TaiHHe/ECE-477/PCB_Relay/Nowboard.brd

## EAGLE design PCB_Relay/Nowboard.brd (2019-04-04)

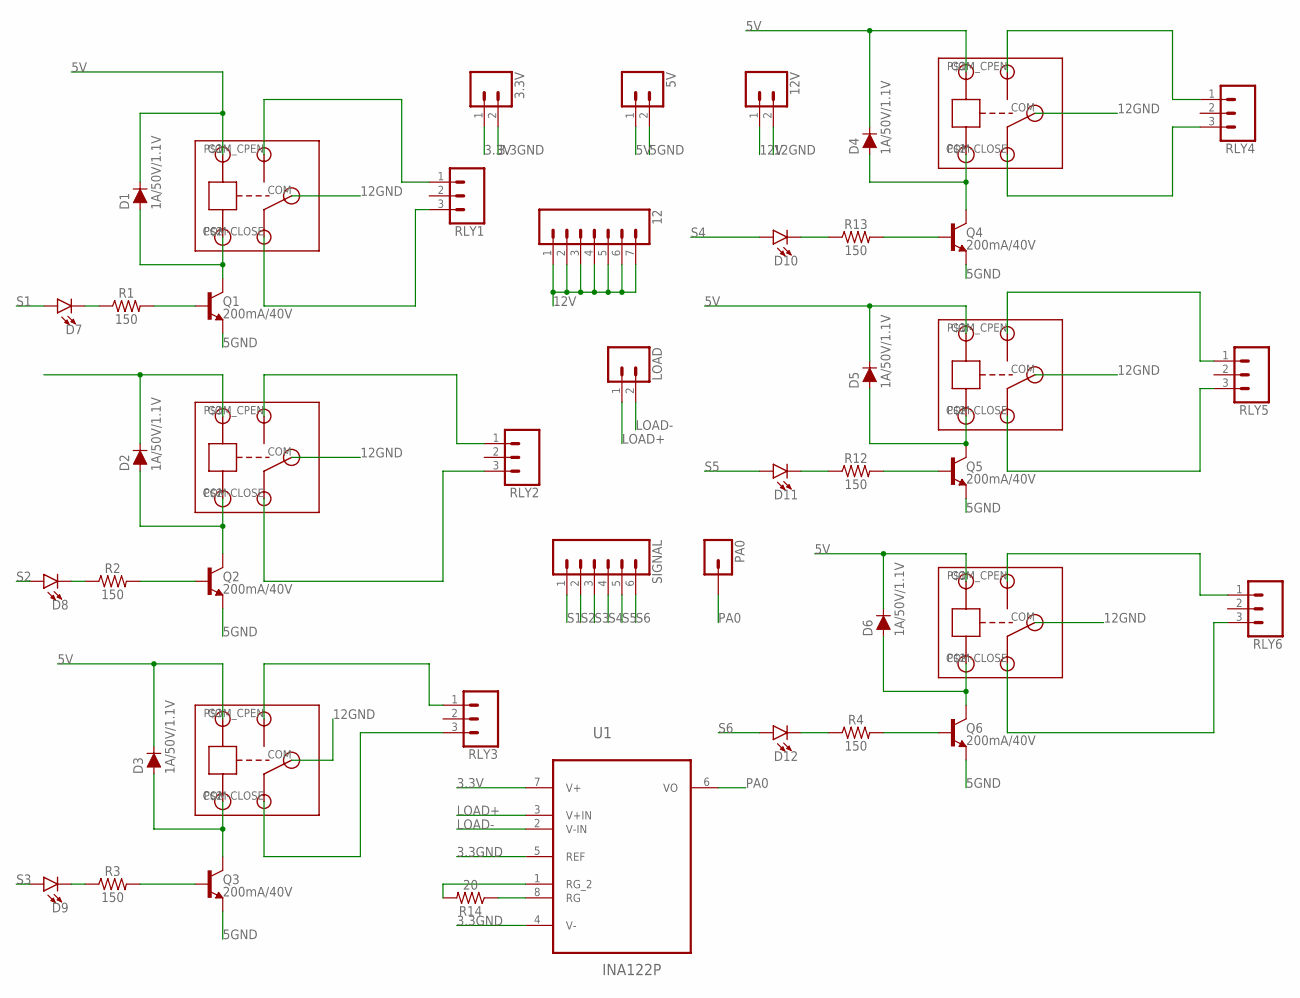
[picture p1: schematic Nowboard.sch]

Parts:
3.3V, 5V, 12V: CONN_02; 1X02
12: CONN_07; 1X07
D1, D2, D3, D4, D5, D6: 1A/50V/1.1V; DIODE-1N4001
D7, D8, D9, D10, D11, D12: LED3MM; LED_3MM
LOAD: CONN_02; 1X02
PA0: CONN_01; 1X01
Q1, Q2, Q3, Q4, Q5, Q6: 200mA/40V; TO-92
R1, R2, R3, R4, R12, R13: 150; 0603
R14: 20; 0603
RELAY1, RELAY2, RELAY3, RELAY4, RELAY5, RELAY6: RELAY
RLY1, RLY2, RLY3, RLY4, RLY5, RLY6: CONN_03; 1X03
SIGNAL: CONN_06NO_SILK_FEMALE_PTH; 1X06_NO_SILK
U1: INA122P; DIP254P762X508-8

Connections:
3.3GND: 3.3V.2, U1.4 (V-), U1.5 (REF)
3.3V: 3.3V.1, U1.7 (V+)
5GND: 5V.2, Q1.1 (E), Q2.1 (E), Q3.1 (E), Q4.1 (E), Q5.1 (E), Q6.1 (E)
5V: 5V.1, D1.C, D3.C, D4.C, D5.C, D6.C, RELAY1.P$1 (IN), RELAY3.P$1 (IN), RELAY4.P$1 (IN), RELAY5.P$1 (IN), RELAY6.P$1 (IN)
12GND: 12V.2, RELAY1.COM, RELAY2.COM, RELAY3.COM, RELAY4.COM, RELAY5.COM, RELAY6.COM
12V: 12.1, 12.2, 12.3, 12.4, 12.5, 12.6, 12.7, 12V.1
LOAD+: LOAD.1, U1.3 (V+IN)
LOAD-: LOAD.2, U1.2 (V-IN)
unnamed: D1.A, Q1.3 (C), RELAY1.P$2 (GND)
unnamed: R14.1, U1.8 (RG)
unnamed: RELAY3.COM-CLOSE, RLY3.3
unnamed: RELAY4.COM_CPEN (COM-OPEN), RLY4.1
unnamed: D2.A, Q2.3 (C), RELAY2.P$2 (GND)
unnamed: D3.A, Q3.3 (C), RELAY3.P$2 (GND)
unnamed: D6.A, Q6.3 (C), RELAY6.P$2 (GND)
unnamed: D5.A, Q5.3 (C), RELAY5.P$2 (GND)
unnamed: D4.A, Q4.3 (C), RELAY4.P$2 (GND)
unnamed: Q4.2 (B), R13.2
unnamed: Q5.2 (B), R12.2
unnamed: Q6.2 (B), R4.2
unnamed: D12.K (C), R4.1
unnamed: D11.K (C), R12.1
unnamed: D10.K (C), R13.1
unnamed: Q3.2 (B), R3.2
unnamed: D9.K (C), R3.1
unnamed: D8.K (C), R2.1
unnamed: Q2.2 (B), R2.2
unnamed: D7.K (C), R1.1
unnamed: Q1.2 (B), R1.2
unnamed: RELAY1.COM-CLOSE, RLY1.3
unnamed: RELAY1.COM_CPEN (COM-OPEN), RLY1.1
unnamed: RELAY2.COM-CLOSE, RLY2.3
unnamed: D2.C, RELAY2.P$1 (IN)
unnamed: RELAY4.COM-CLOSE, RLY4.3
unnamed: RELAY3.COM_CPEN (COM-OPEN), RLY3.1
unnamed: RELAY2.COM_CPEN (COM-OPEN), RLY2.1
unnamed: RELAY6.COM-CLOSE, RLY6.3
unnamed: RELAY6.COM_CPEN (COM-OPEN), RLY6.1
unnamed: RELAY5.COM-CLOSE, RLY5.3
unnamed: RELAY5.COM_CPEN (COM-OPEN), RLY5.1
unnamed: R14.2, U1.1 (RG_2)
PA0: PA0.1, U1.6 (VO)
S1: D7.A, SIGNAL.1
S2: D8.A, SIGNAL.2
S3: D9.A, SIGNAL.3
S4: D10.A, SIGNAL.4
S5: D11.A, SIGNAL.5
S6: D12.A, SIGNAL.6

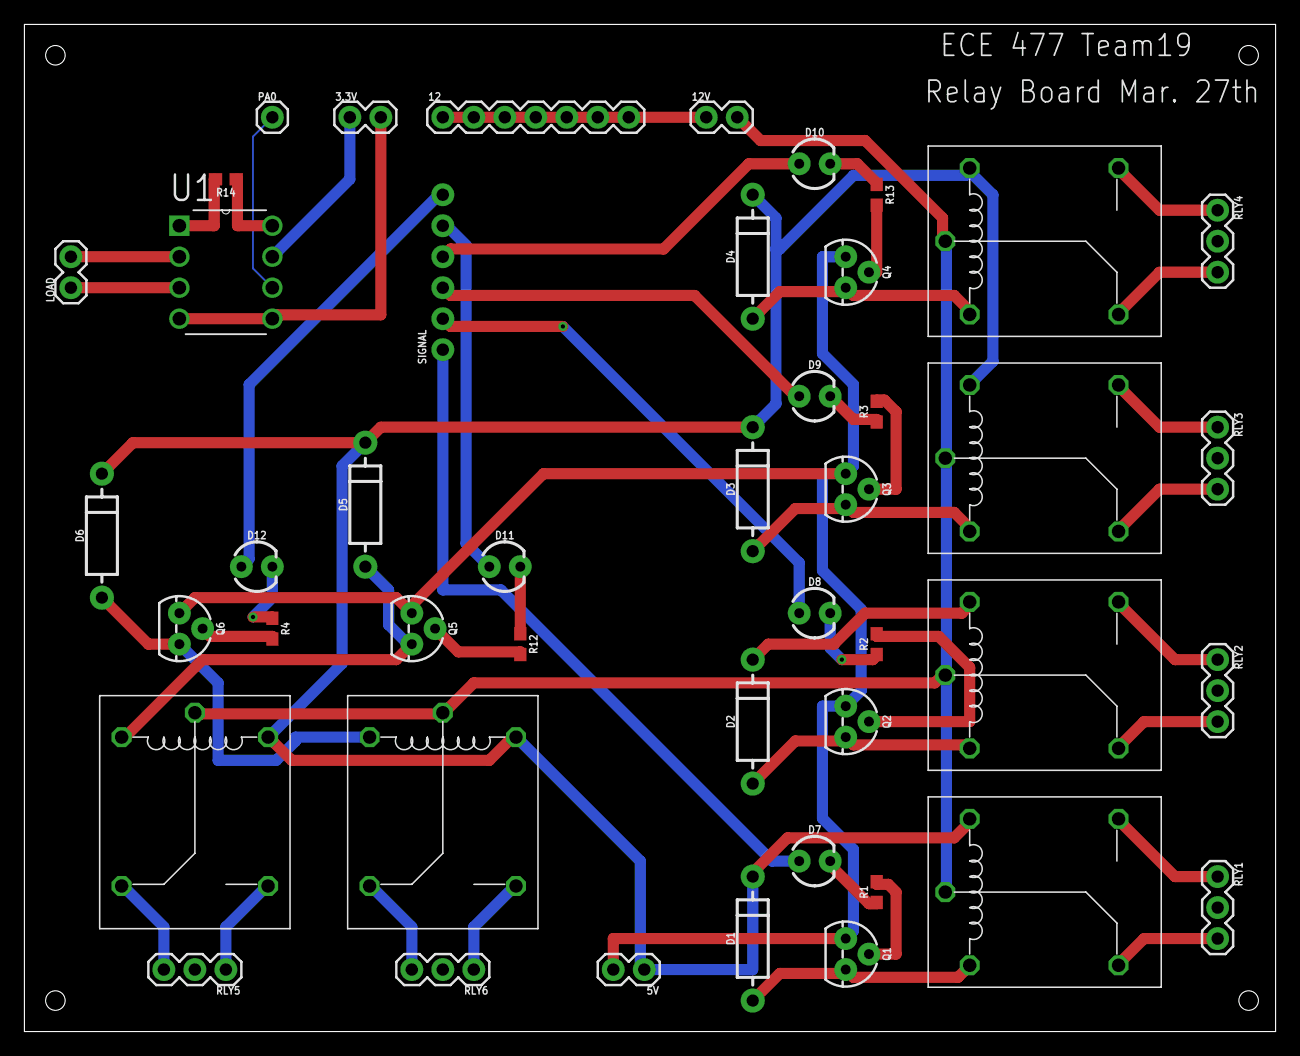
[picture p2: board Nowboard.brd from above]

Board: 2 copper layers, 102.5 x 82.5 mm, 45 parts (0 on the bottom side), 48 nets.
