TaiHHe/ECE-477/PCB_Main/477.brd

## EAGLE design PCB_Main/477.brd (2019-04-29)

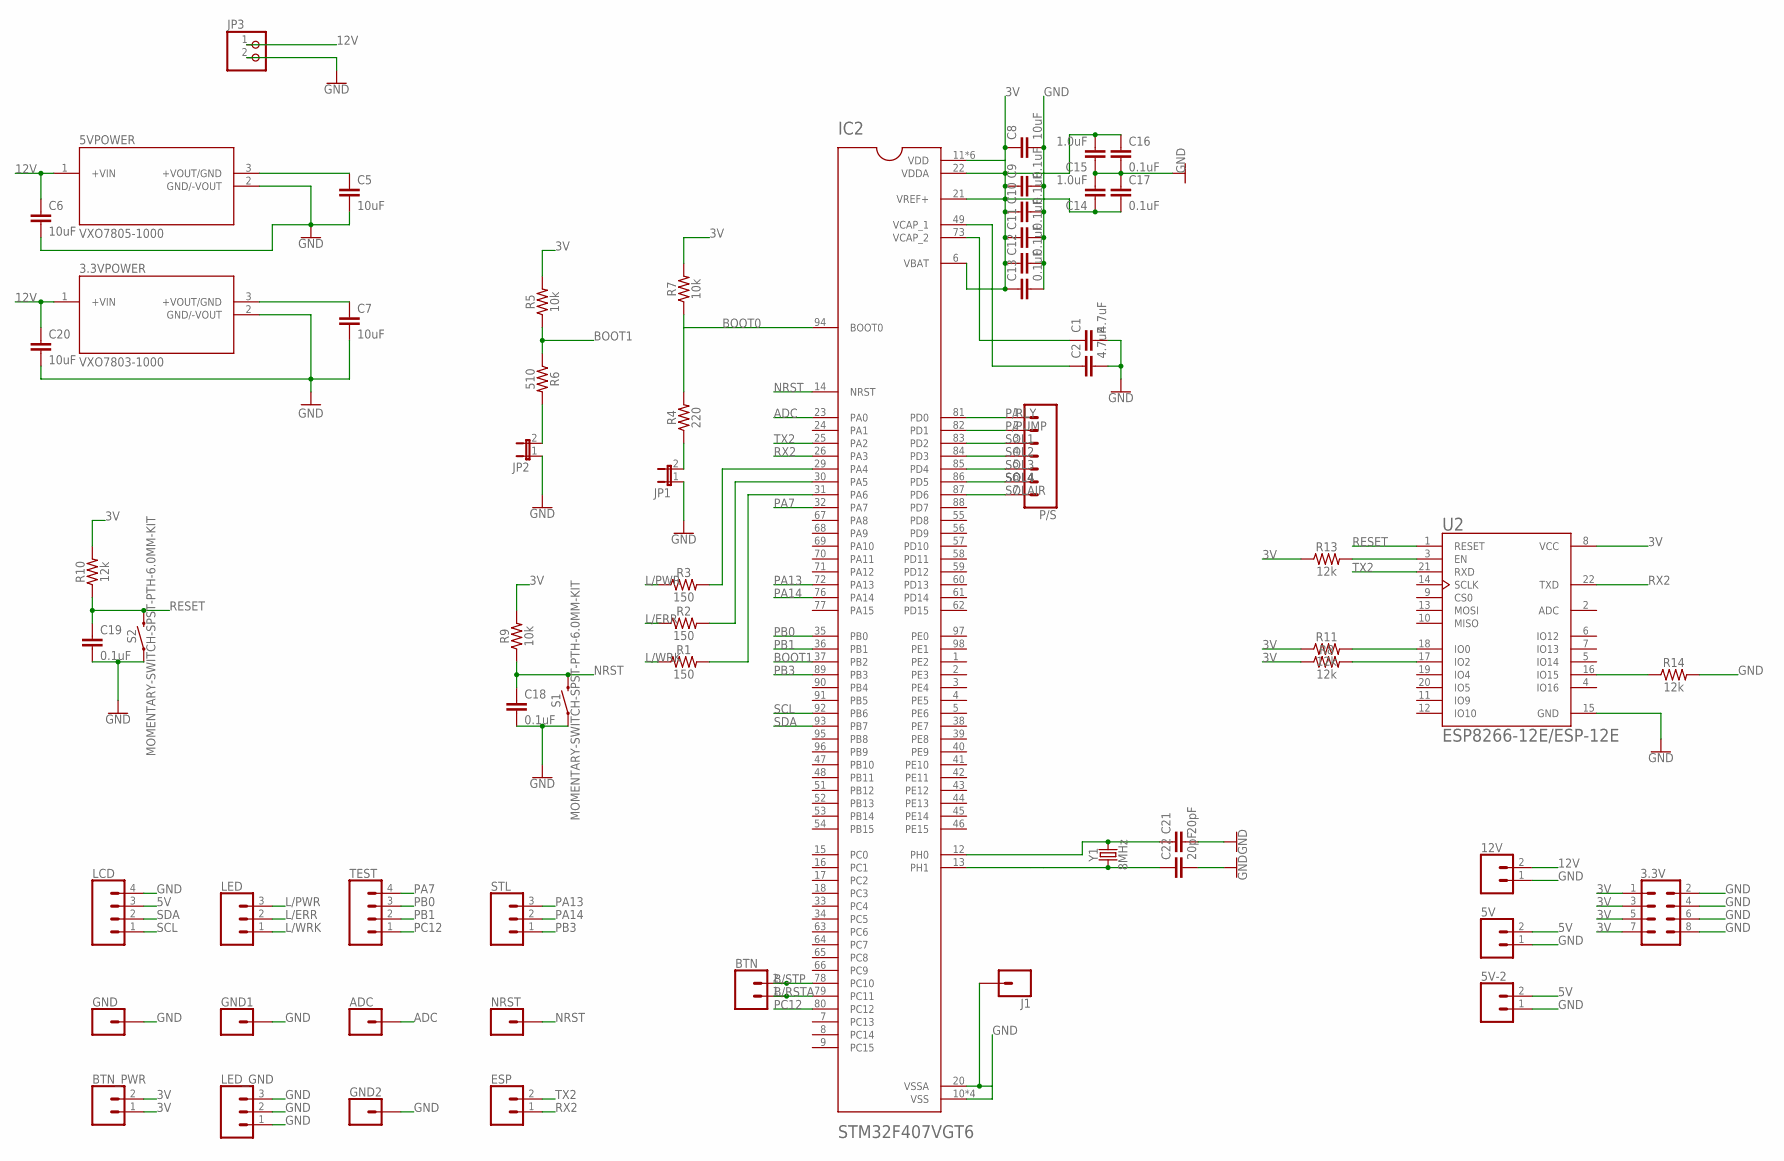
[picture p3: schematic 477.sch]

Parts:
3.3V: CONN_04X2; 2X4
3.3VPOWER: VXO7803-1000; CONV_VXO7803-1000
5V, 5V-2, 12V: CONN_02; 1X02
5VPOWER: VXO7805-1000; CONV_VXO7805-1000
ADC: CONN_01; 1X01
BTN: CONN_02; 1X02
BTN_PWR: CONN_02; 1X02
C1, C2: 4.7uF; 0603
C5, C6, C7, C8, C20: 10uF; 0603
C9, C10, C11, C12, C13, C16, C17, C18, C19: 0.1uF; 0402
C14, C15: 1.0uF; 0402
C21, C22: 20pF; 0603
ESP: CONN_02; 1X02
GND, GND1: CONN_01PTH_NO_SILK_YES_STOP; 1X01_NO_SILK
GND2: CONN_01; 1X01
IC2: STM32F407VGT6; QFP50P1600X1600X160-100N
J1: CONN_01PTH_NO_SILK_YES_STOP; 1X01_NO_SILK
JP1, JP2: JP1E; JP1
JP3: PINHD-1X2; 1X02
LCD: CONN_04; 1X04
LED: CONN_03; 1X03
LED_GND: CONN_03; 1X03
NRST: CONN_01; 1X01
P/S: CONN_07; 1X07
R1, R2, R3: 150; 0603
R4: 220; 0603
R5, R7, R9: 10k; 0603
R6: 510; 0603
R8, R10, R11, R13, R14: 12k; 0603
S1, S2: MOMENTARY-SWITCH-SPST-PTH-6.0MM-KIT; TACTILE_SWITCH_PTH_6.0MM_KIT
STL: CONN_03; 1X03
TEST: CONN_04; 1X04
U2: ESP8266-12E/ESP-12E; XCVR_ESP8266-12E/ESP-12E
Y1: 8MHz; HC49UP

Connections:
3V: 3.3V.1, 3.3V.3, 3.3V.5, 3.3V.7, 3.3VPOWER.3 (+VOUT/GND), BTN_PWR.1, BTN_PWR.2, C7.1, C8.1, C9.1, C10.1, C11.1, C12.1, C13.1, C14.1, C15.2, C16.1, C17.2, IC2.6 (VBAT), IC2.11 (VDD), IC2.19 (VDD), IC2.21 (VREF+), IC2.22 (VDDA), IC2.28 (VDD), IC2.50 (VDD), IC2.75 (VDD), IC2.100 (VDD), R5.2, R7.2, R8.1, R9.2, R10.2, R11.1, R13.1, U2.8 (VCC)
5V: 5V.2, 5V-2.2, 5VPOWER.3 (+VOUT/GND), C5.1, LCD.3
12V: 3.3VPOWER.1 (+VIN), 5VPOWER.1 (+VIN), 12V.2, C6.1, C20.1, JP3.1
ADC: ADC.1, IC2.23 (PA0)
B/RSTA: BTN.1, IC2.79 (PC11)
B/STP: BTN.2, IC2.78 (PC10)
BOOT0: IC2.94 (BOOT0), R4.2, R7.1
BOOT1: IC2.37 (PB2), R5.1, R6.1
EN: R13.2, U2.3 (EN)
GND: 3.3V.2, 3.3V.4, 3.3V.6, 3.3V.8, 3.3VPOWER.2 (GND/-VOUT), 5V.1, 5V-2.1, 5VPOWER.2 (GND/-VOUT), 12V.1, C1.2, C2.2, C5.2, C6.2, C7.2, C8.2, C9.2, C10.2, C11.2, C12.2, C13.2, C14.2, C15.1, C16.2, C17.1, C18.2, C19.2, C20.2, C21.2, C22.2, GND.1, GND1.1, GND2.1, IC2.10 (VSS), IC2.27 (VSS), IC2.74 (VSS), IC2.99 (VSS), JP1.1, JP2.1, JP3.2, LCD.4, LED_GND.1, LED_GND.2, LED_GND.3, R14.2, S1.1, S2.1, U2.15 (GND)
L/ERR: LED.2, R2.1
L/PWR: LED.3, R3.1
L/WRK: LED.1, R1.1
unnamed: IC2.29 (PA4), R3.2
unnamed: IC2.30 (PA5), R2.2
unnamed: C22.1, IC2.13 (PH1), Y1.1
unnamed: IC2.31 (PA6), R1.2
unnamed: R11.2, U2.18 (IO0)
unnamed: R8.2, U2.17 (IO2)
unnamed: R14.1, U2.16 (IO15)
unnamed: C21.1, IC2.12 (PH0), Y1.2
unnamed: C1.1, IC2.73 (VCAP_2)
unnamed: JP2.2, R6.2
unnamed: C2.1, IC2.49 (VCAP_1)
unnamed: IC2.20 (VSSA), J1.1
unnamed: JP1.2, R4.1
NRST: C18.1, IC2.14 (NRST), NRST.1, R9.1, S1.3 (2)
P/PUMP: IC2.82 (PD1), P/S.2
P/RLY: IC2.81 (PD0), P/S.1
PA7: IC2.32 (PA7), TEST.4
PA13: IC2.72 (PA13), STL.3
PA14: IC2.76 (PA14), STL.2
PB0: IC2.35 (PB0), TEST.3
PB1: IC2.36 (PB1), TEST.2
PB3: IC2.89 (PB3), STL.1
PC12: IC2.80 (PC12), TEST.1
RESET: C19.1, R10.1, S2.3 (2), U2.1 (RESET)
RX2: ESP.1, IC2.26 (PA3), U2.22 (TXD)
SCL: IC2.92 (PB6), LCD.1
SDA: IC2.93 (PB7), LCD.2
SOL1: IC2.83 (PD2), P/S.3
SOL2: IC2.84 (PD3), P/S.4
SOL3: IC2.85 (PD4), P/S.5
SOL4: IC2.86 (PD5), P/S.6
SOLAIR: IC2.87 (PD6), P/S.7
TX2: ESP.2, IC2.25 (PA2), U2.21 (RXD)

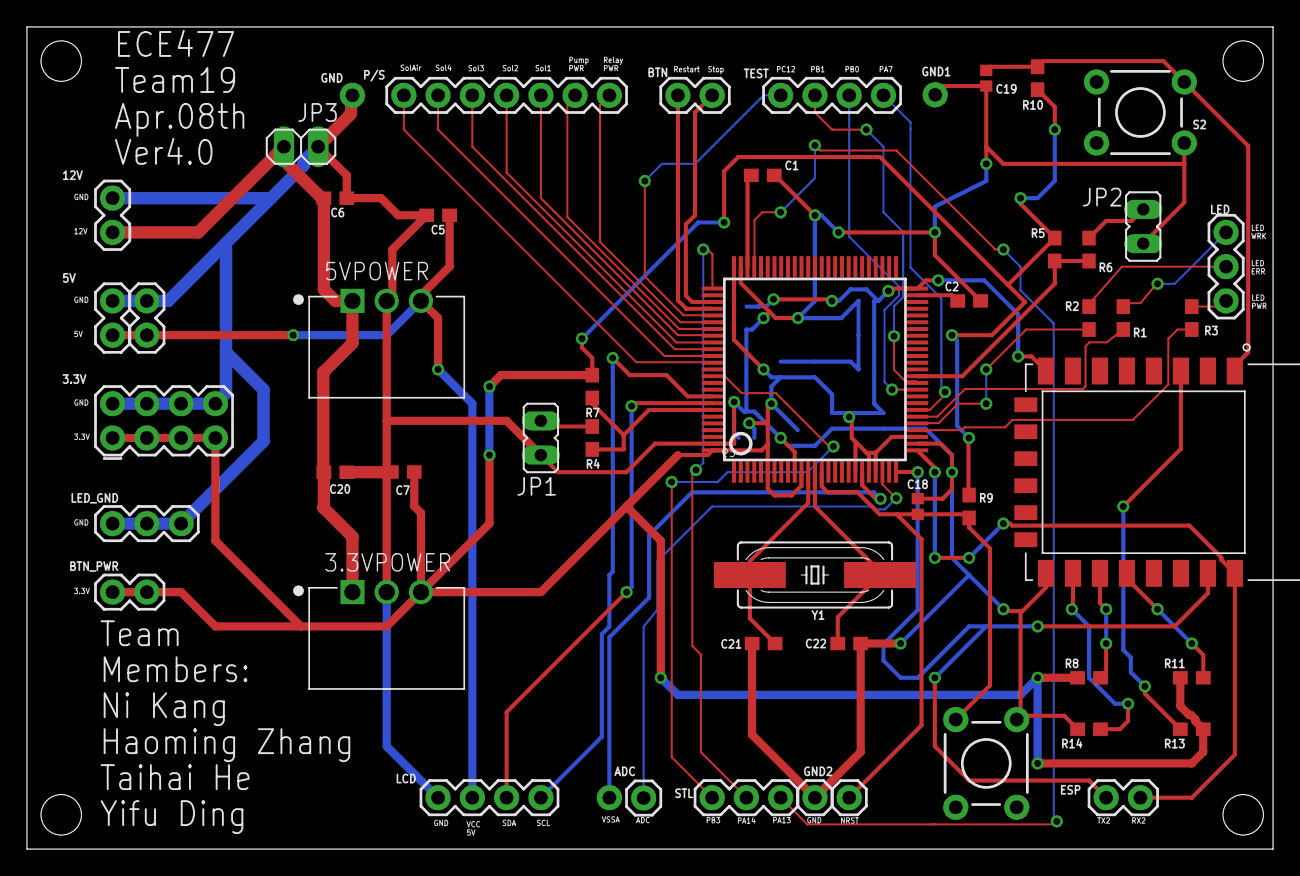
[picture p4: board 477.brd from above]

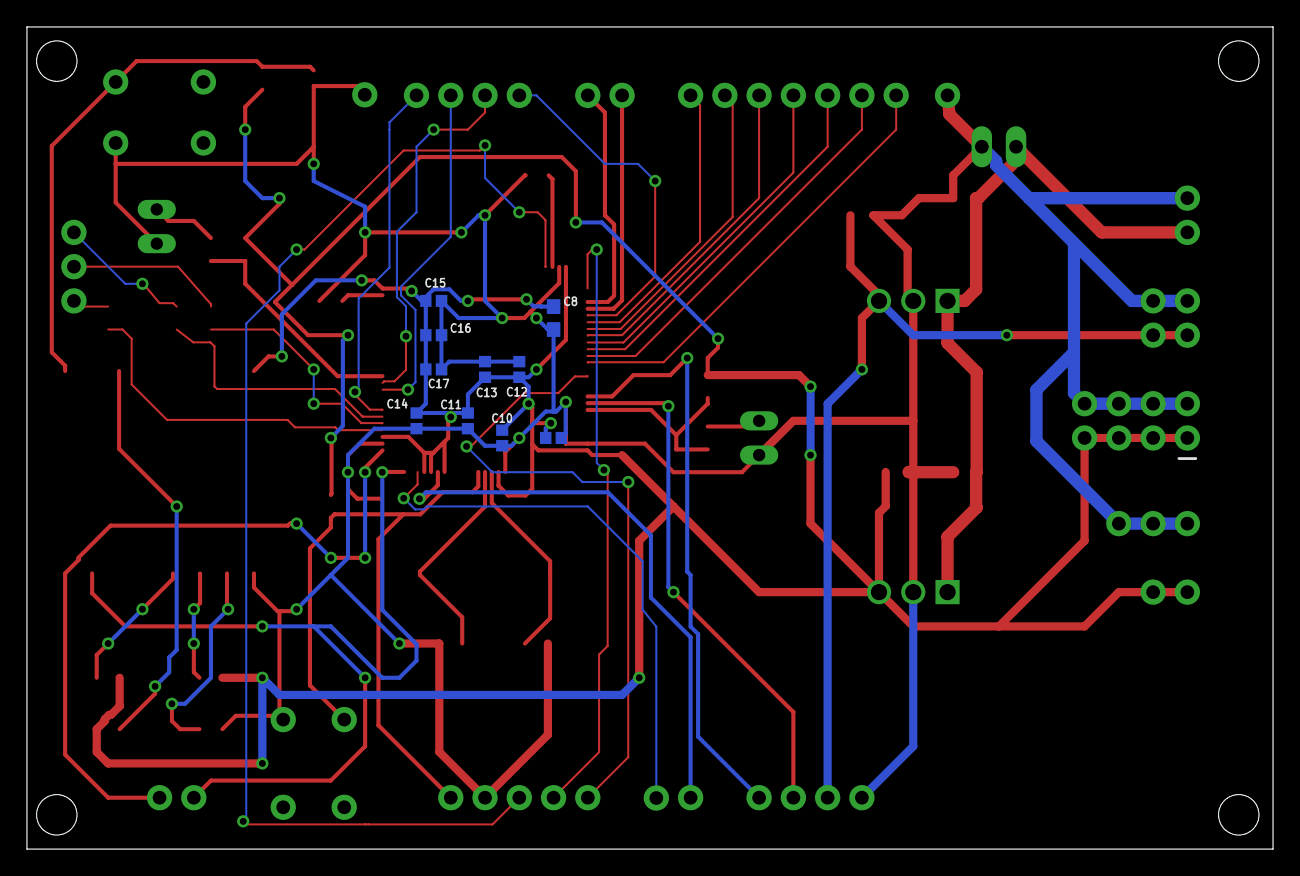
[picture p5: board 477.brd from below]

Board: 2 copper layers, 92.4 x 60.9 mm, 62 parts (10 on the bottom side), 46 nets.
