TaiHHe/ECE-477/XMixer_Max/Src/main.c

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

/* Includes ------------------------------------------------------------------*/
#include "main.h"

/* USER CODE BEGIN Includes */
#include "i2c-lcd.h"
/* USER CODE END Includes */

ADC_HandleTypeDef hadc1;

I2C_HandleTypeDef hi2c1;

TIM_HandleTypeDef htim2;

UART_HandleTypeDef huart2;
UART_HandleTypeDef huart3;

/* USER CODE BEGIN PV */

//Communication msgs for ESP8266
uint8_t initMsg[] = "init\n";
uint8_t errorMsg[] = "error\n";
uint8_t startMsg[] = "start\n";
uint8_t doneMsg[] = "done\n";
uint8_t ofMsg[] = "overflow\n";

//Test msgs
uint8_t welcomeMessage[] = "Thank you for choosing XMixer Max!\n";
uint8_t selectMessage[] = "Please select the drinks with their ratios.\n";
uint8_t updateMessage[] = "Updating drink information...\n";
uint8_t receiveMessage[] = "Receiving message...\n";
uint8_t vol1Msg[] = "The volume of drink 1 is: ";
uint8_t vol2Msg[] = "The volume of drink 2 is: ";
uint8_t vol3Msg[] = "The volume of drink 3 is: ";
uint8_t vol4Msg[] = "The volume of drink 4 is: ";
uint8_t mlMsg[] = " ml.\n";
uint8_t reply[] = "I received: ";

//Variables
uint8_t pData;
uint8_t buffer[100];
uint8_t numBuffer[10];
int numBufIdx = 0;
int i = 0;
int LF = 0;
int CurIdx;
int status = STATUS_INIT;
int timeout = 0; //2 usages
int overflow = 0;
int tim; //working time passed to TIM2 handler
/* USER CODE END PV */

void SystemClock_Config(void);
static void MX_GPIO_Init(void);
static void MX_I2C1_Init(void);
static void MX_USART2_UART_Init(void);
static void MX_USART3_UART_Init(void);
static void MX_TIM2_Init(void);
static void MX_ADC1_Init(void);
/* USER CODE BEGIN PFP */
void Drink_Transfer(int sol, int time);
void Timer_Enable();
void Timer_Disable();
void System_Test();
/* USER CODE END PFP */

/**
  * @brief  The application entry point.
  * @retval int
  */
int main(void)
{
  /* USER CODE BEGIN 1 */
	int Vol1;
	int Vol2;
	int Vol3;
	int Vol4;
	int VolDel;
	int Time1;
	int Time2;
	int Time3;
	int Time4;

	int offlag;
  /* USER CODE END 1 */

  /* MCU Configuration--------------------------------------------------------*/

  /* Reset of all peripherals, Initializes the Flash interface and the Systick. */
  HAL_Init();

  /* Configure the system clock */
  SystemClock_Config();

  /* Initialize all configured peripherals */
  MX_GPIO_Init();
  MX_I2C1_Init();
  MX_USART2_UART_Init();
  MX_USART3_UART_Init();
  MX_TIM2_Init();
  MX_ADC1_Init();
  /* USER CODE BEGIN 2 */

  // System starts. Initialize LCD and UAR, turn a green LED to show the status. Wait for Internet connection.
  // Send msg to ESP first and then waiting for reply to check the connection
  // Software is responsible for verifying bidirectional connection with the server
  i = 0;
  lcd_init();
  lcd_send_cmd(0x01);
  lcd_send_cmd(0x02);
  lcd_send_string("plThank you for");
  lcd_send_cmd(0xc0);
  lcd_send_string("using XMixer Max");
  HAL_GPIO_WritePin(LED_Power_GPIO_Port, LED_Power_Pin, GPIO_PIN_SET);
  HAL_Delay(4000);
  lcd_send_cmd(0x01);
  lcd_send_cmd(0x02);
  lcd_send_string("plTrying to con");
  lcd_send_cmd(0xc0);
  lcd_send_string("nect to Internet");
  HAL_UART_Receive_IT(&huart2, &pData, 1);
  HAL_UART_Transmit(&huart2, initMsg, sizeof(initMsg), 100);
  ADC1 -> CR2 |= ADC_CR2_ADON;
  HAL_GPIO_WritePin(LED_Error_GPIO_Port, LED_Error_Pin, GPIO_PIN_RESET);

  HAL_Delay(4000);
  lcd_send_cmd(0x01);
  lcd_send_cmd(0x02);
  lcd_send_string("plPlease select");
  lcd_send_cmd(0xc0);
  lcd_send_string("drinks!");
  /*do {
	  if ((LF == 1) && (timeout == 0)) {
		  //Keep trying as long as 30 seconds have not passed since last restart.
		  LF = 0;
		  lcd_send_cmd(0x01);
		  lcd_send_cmd(0x02);
		  HAL_UART_Receive_IT(&huart2, &pData, 1);
		  if (buffer == "success\n") {
			  //Connection established. Start working.
			  status = STATUS_IDLE;
			  lcd_send_string("plPlease select");
			  lcd_send_cmd(0xc0);
			  lcd_send_string("drinks!");
		  } else if (buffer == "fail\n") {
			  //Connection failed. Reconnecting.
			  status = STATUS_ERROR;
			  lcd_send_string("plNo WiFi found");
			  lcd_send_cmd(0xc0);
			  lcd_send_string("Reconnecting...");
		  }
	  } else if (timeout == 1) {
		  //Have Waited for 30 seconds. Update LCD if still no connection, and turn a red LED PD1 on to indicate error. Then wait for button input to start over.
		  if (HAL_GPIO_ReadPin(Button_Restart_GPIO_Port, Button_Restart_Pin) == 1) {
			  //Button pressed. Start over.
			  timeout = 0;
			  status = STATUS_INIT;
			  HAL_GPIO_WritePin(LED_Error_GPIO_Port, LED_Error_Pin, GPIO_PIN_RESET);
			  lcd_send_cmd(0x01);
			  lcd_send_cmd(0x02);
			  lcd_send_string("plReconnecting...");
		  } else {
			  //Timeout
			  HAL_GPIO_WritePin(LED_Error_GPIO_Port, LED_Error_Pin, GPIO_PIN_SET);
			  lcd_send_cmd(0x01);
			  lcd_send_cmd(0x02);
			  if (status == STATUS_INIT) {
				  lcd_send_string("plWiFi module");
				  lcd_send_cmd(0xc0);
				  lcd_send_string("malfunctioning");
			  } else if (status == STATUS_ERROR) {
				  lcd_send_string("plPlease check");
				  lcd_send_cmd(0xc0);
				  lcd_send_string("WiFi signal");
			  }
		  }
	  }
   } while (status != STATUS_IDLE);
*/
  timeout = 0;
  /* USER CODE END 2 */

  /* Infinite loop */
  /* USER CODE BEGIN WHILE */
  while (1)
  {
    /* USER CODE END WHILE */

    /* USER CODE BEGIN 3 */
	  //Check if any information is received.
	  HAL_GPIO_WritePin(LED_Error_GPIO_Port, LED_Error_Pin, GPIO_PIN_RESET);
	  if (LF == 1) {
		  offlag = 0;
		  LF = 0;
		  i = 0;
		  if ((buffer[0] == 49) || (buffer[0] == 10)) { // /n or 1
			  //Order received, parse information
			  CurIdx = 1;
			  numBufIdx = 0;
			  VolDel = 0;
			  while(buffer[CurIdx] != 100) { // d
				  if (buffer[CurIdx] == 44) { // ,
					  CurIdx += 1;
		  	  	  	  while (buffer[CurIdx] != 46) { // .
		  	  	  		  numBuffer[numBufIdx] = buffer[CurIdx];
		  	  	  		  numBufIdx += 1;
		  	  	  		  CurIdx += 1;
		  	  	  	  }
		  	  	  	  numBuffer[numBufIdx] = 0;
		  	  	  	  if (VolDel == 0) {
		  	  	  		  Vol1 = atoi(numBuffer);
		  	  	  		  //HAL_UART_Transmit(&huart3, vol1Msg, sizeof(vol1Msg), 100);
		  	  	  	  } else if (VolDel == 1) {
		  	  	  		  Vol2 = atoi(numBuffer);
		  	  	  		  //HAL_UART_Transmit(&huart3, vol2Msg, sizeof(vol2Msg), 100);
		  	  	  	  } else if (VolDel == 2) {
		  	  	  		  Vol3 = atoi(numBuffer);
		  	  	  		  //HAL_UART_Transmit(&huart3, vol3Msg, sizeof(vol3Msg), 100);
		  	  	  	  } else if (VolDel == 3) {
		  	  	  		  Vol4 = atoi(numBuffer);
		  	  	  		  //HAL_UART_Transmit(&huart3, vol4Msg, sizeof(vol4Msg), 100);
		  	  	  	  }
		  	  	  	  VolDel += 1;
		  	  	  	  numBufIdx = 0;
		  	  	  	  //HAL_UART_Transmit(&huart3, numBuffer, sizeof(numBuffer), 100);
		  	  	  	  //HAL_UART_Transmit(&huart3, mlMsg, sizeof(mlMsg), 100);
			  	  }
			  CurIdx += 1;
	  	  	  }
			  lcd_send_cmd(0x01);
			  lcd_send_cmd(0x02);
			  lcd_send_string("plOrder received");
			  lcd_send_cmd(0xc0);
			  lcd_send_string("Mixing");
			  status = STATUS_READY;
			  //HAL_UART_Transmit(&huart3,h		ccc startMsg, sizeof(startMsg), 100);
		  }
		  //For now, assume no other information would be received, and the process would not be interrupted.
		  else {
			  //Indicate information is not recognizable
			  HAL_UART_Transmit(&huart2, errorMsg, sizeof(errorMsg), 100);
		  }
		  i = 0;
		  HAL_UART_Receive_IT(&huart2, &pData, 1);
	  }
//	  Vol1 = 20;
//	  Vol2 = 20;
//	  Vol3 = 20;
//	  Vol4 = 20;
//	  System_Test();

	  if (status == STATUS_READY) {
//		  if ((Vol1 + Vol2 + Vol3 + Vol4) > 300) {
//			  offlag = 1;
//			  Vol1 = (Vol1 > 300) ? 300: Vol1;
//			  Vol2 = ((Vol1 + Vol2) > 300) ? (300 - Vol1) : Vol2;
//			  Vol3 = ((Vol1 + Vol2 + Vol3) > 300) ? (300 - Vol1 - Vol2) : Vol3;
//			  Vol4 = 300 - Vol1 - Vol2 - Vol3;
//		  }
//		  Vol1 = (Vol1 - 10) * 2;
//		  Vol2 = (Vol2 - 10) * 2;
//		  Vol3 = (Vol3 - 10) * 2;
//		  Vol3 = (Vol4 - 10) * 2;
//		  Vol1 *= 1.15;
//		  Vol2 *= 1.15;
//		  Vol3 *= 1.15;
//		  Vol3 *= 1.15;
		  //Start mixing, need to calculate the time with the speed 7.5 ml/s
		  Timer_Enable();
		  Time1 = Vol1/SPEED1;
		  Time2 = Vol2/SPEED2;
		  Time3 = Vol3/SPEED3;
		  Time4 = Vol4/SPEED4;
		  HAL_GPIO_WritePin(LED_Working_GPIO_Port, LED_Working_Pin, GPIO_PIN_SET);
		  HAL_GPIO_WritePin(Relay_Power_GPIO_Port, Relay_Power_Pin, GPIO_PIN_SET); //Turn on the relay
		  HAL_GPIO_WritePin(Pump_Power_GPIO_Port, Pump_Power_Pin, GPIO_PIN_SET); //Turn on the pump, as PC10 in the pump test

		  Drink_Transfer(1, Time1);
		  if (!overflow) {
			  Drink_Transfer(2, Time2);
			  if (!overflow) {
				  Drink_Transfer(3, Time3);
				  if (!overflow) {
					  Drink_Transfer(4, Time4);
				  }
			  }
		  }

		  HAL_GPIO_WritePin(Pump_Power_GPIO_Port, Pump_Power_Pin, GPIO_PIN_RESET); //Turn off the pump
		  HAL_GPIO_WritePin(Relay_Power_GPIO_Port, Relay_Power_Pin, GPIO_PIN_RESET); //Turn off the relay
		  status = STATUS_IDLE;

		  //Update LED, LCD and the web site
		  HAL_GPIO_WritePin(LED_Working_GPIO_Port, LED_Working_Pin, GPIO_PIN_RESET);
		  if (!overflow && !offlag) {
			  lcd_send_cmd(0x01);
			  lcd_send_cmd(0x02);
			  lcd_send_string("plOrder");
			  lcd_send_cmd(0xc0);
			  lcd_send_string("completed!");
			  HAL_UART_Transmit(&huart2, doneMsg, sizeof(doneMsg), 100);
		  } else {
			  HAL_GPIO_WritePin(LED_Error_GPIO_Port, LED_Error_Pin, GPIO_PIN_SET);
			  lcd_send_cmd(0x01);
			  lcd_send_cmd(0x02);
			  lcd_send_string("plAlmost full!");
			  lcd_send_cmd(0xc0);
			  lcd_send_string("Stop mixing!");
			  HAL_UART_Transmit(&huart2, ofMsg, sizeof(ofMsg), 100);
			  overflow = 0;
		  }
		  Vol1 = 0;
		  Vol2 = 0;
		  Vol3 = 0;
		  Vol4 = 0;
		  offlag = 0;
		  Timer_Disable();
		  HAL_Delay(10000);
		  lcd_send_cmd(0x01);
		  lcd_send_cmd(0x02);
		  lcd_send_string("plPlease select");
		  lcd_send_cmd(0xc0);
		  lcd_send_string("drinks!");
		  HAL_Delay(3000);
	  }
  }
  /* USER CODE END 3 */
}

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
/* USER CODE BEGIN 4 */
void Timer_Enable() {
	TIM2->DIER |= 0x0001;
	TIM2->CR1 |= TIM_CR1_CEN;
	NVIC->ISER[0] |= 0x10000000;
}

void Timer_Disable() {
	TIM2->DIER &= 0xFFFE;
	TIM2->CR1 &= !TIM_CR1_CEN;
	NVIC->ISER[0] &= 0xEFFFFFFF;
}

void Drink_Transfer(int sol, int time) {
	GPIO_TypeDef *port;
	uint16_t pin;
	switch (sol) {
	case 1:
		port = Solenoid_1_GPIO_Port;
		pin = Solenoid_1_Pin;
		break;
	case 2:
		port = Solenoid_2_GPIO_Port;
		pin = Solenoid_2_Pin;
		break;
	case 3:
		port = Solenoid_3_GPIO_Port;
		pin = Solenoid_3_Pin;
		break;
	case 4:
		port = Solenoid_4_GPIO_Port;
		pin = Solenoid_4_Pin;
		break;
	case 5:
		port = Solenoid_Air_GPIO_Port;
		pin = Solenoid_Air_Pin;
		break;
	default:
		port = Solenoid_Air_GPIO_Port;
		pin = Solenoid_Air_Pin;
		break;
	}

	tim = time;
	timeout = 0;
	HAL_GPIO_WritePin(port, pin, GPIO_PIN_SET); //Open solenoid
	status = STATUS_MIXING;
	while (timeout == 0) {
		if (overflow) {
			break;
		}
	}
	HAL_GPIO_WritePin(port, pin, GPIO_PIN_RESET); //Close solenoid
	HAL_Delay(1000); //Wait for a little bit: 1.5s
	if (time != 0) {
		HAL_GPIO_WritePin(Solenoid_Air_GPIO_Port, Solenoid_Air_Pin, GPIO_PIN_SET); //Open solenoid Air
		HAL_Delay(3000);
		HAL_GPIO_WritePin(Solenoid_Air_GPIO_Port, Solenoid_Air_Pin, GPIO_PIN_RESET); //Open solenoid Air
	}
	status = STATUS_READY;
	HAL_Delay(1000); //Wait for a little bit: 1.5s
}

void System_Test() {
	HAL_Delay(3000);
	lcd_send_cmd(0x01);
	lcd_send_cmd(0x02);
	lcd_send_string("plOrder received");
	lcd_send_cmd(0xc0);
	lcd_send_string("Mixing");
	status = STATUS_READY;
}

void HAL_UART_RxCpltCallback(UART_HandleTypeDef *huart)
{
	if (pData == 33) {//!
		i--;
		LF = 1;
	} else {
		buffer[i] = pData;
		i++;
		HAL_UART_Receive_IT(&huart2, &pData, 1);
	}

}
/* USER CODE END 4 */
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
