TaiHHe/ECE-477/XMixer_Max/XMixer_Max.ioc

Mcu.UserName=STM32F407VGTx
PA0-WKUP.Signal=ADCx_IN0
PA2.Signal=USART2_TX
PA3.Signal=USART2_RX
PA4.GPIO_Label=LED_Power
PA4.Signal=GPIO_Output
PA5.GPIO_Label=LED_Error
PA5.Signal=GPIO_Output
PA6.GPIO_Label=LED_Working
PA6.Signal=GPIO_Output
PA7.Signal=GPIO_Output
PB0.Signal=GPIO_Output
PB1.Signal=GPIO_Output
PB10.Signal=USART3_TX
PB11.Signal=USART3_RX
PB2.GPIO_Label=Boot1
PB2.Signal=GPIO_Output
PB6.Signal=I2C1_SCL
PB7.Signal=I2C1_SDA
PC10.GPIO_Label=Button_Stop
PC10.Signal=GPIO_Input
PC11.GPIO_Label=Button_Restart
PC11.Signal=GPIO_Input
PC12.Signal=GPIO_Input
PD0.GPIO_Label=Relay_Power
PD0.Signal=GPIO_Output
PD1.GPIO_Label=Pump_Power
PD1.Signal=GPIO_Output
PD2.GPIO_Label=Solenoid_1
PD2.Signal=GPIO_Output
PD3.GPIO_Label=Solenoid_2
PD3.Signal=GPIO_Output
PD4.GPIO_Label=Solenoid_3
PD4.Signal=GPIO_Output
PD5.GPIO_Label=Solenoid_4
PD5.Signal=GPIO_Output
PD6.GPIO_Label=Solenoid_Air
PD6.Signal=GPIO_Output
PH0-OSC_IN.Signal=RCC_OSC_IN
PH1-OSC_OUT.Signal=RCC_OSC_OUT
