TaiHHe/ECE-477/(commit log)

2019-02-15 Finished communication between esp8266 and stm32
2019-02-15 Added Test_UART project
    [New_configuration (2).cfg, New_configuration (6).cfg, Test_UART.cfg]
2019-03-16 Finished the basic sturcture of MCU program.
    [New_configuration (6).cfg, XMixer_Max.cfg]
2019-03-18 ECE-477
    Added PCB files
    [477.brd, 477.sch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]
2019-03-19 Added ADC related logic and modified status checking logic.
2019-03-20 update server and socket code
2019-03-24 update esp8266 settings & server socket listening algorithm
2019-03-27 Added ADC logic and modified mixing logic and GPIO usage. Need to add stop logic.
2019-03-30 Seperate socket connection from server side
2019-03-30 Updated the logic for esp8266 and add shebang line for flask and socket
2019-04-01 Updated PCB files
    Modified main PCB and added the second PCB for relay
    [477.brd, 477.sch, Nowboard.brd, Nowboard.sch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]
2019-04-29 Project Finished
    [477-Vince.brd, 477-Vince.sch, 477.brd, 477.sch, New_configuration (2).cfg, New_configuration (6).cfg, Nowboard.brd, Nowboard.sch]
